Dhruv6576/CYTM-Digital-Timer/docs/superpowers/plans/2026-10-08-timer-pcb.md

# CYTM Digital Timer PCB Implementation Plan

> **For agentic workers:** REQUIRED SUB-SKILL: Use superpowers:subagent-driven-development (recommended) or superpowers:executing-plans to implement this plan task-by-task. Steps use checkbox (`- [ ]`) syntax for tracking.

**Goal:** Generate a complete, DRC/ERC-clean KiCad 10 project (schematic, 2-layer PCB, Gerbers, BOM, renders, 3×2 film panel) for the 24 VDC cyclic timer, from one Python circuit description.

**Architecture:** One Python file (`circuit.py`) holds every part, net and placement. Generators turn it into a `.kicad_sch` (symbols + net labels) and a `.kicad_pcb` (pcbnew API, run with KiCad's bundled Python). Freerouting routes the board through Specctra DSN/SES. `kicad-cli` runs ERC, DRC with schematic parity, and all exports. Plain-assert test scripts check the netlist against the firmware pin map.

**Tech Stack:** KiCad 10.0.6 (`kicad-cli`, bundled Python + `pcbnew`), Freerouting (jar, Java 17), Python 3.10 (user install) + PyMuPDF for the film panel.

**Spec:** `docs/superpowers/specs/2026-10-07-timer-pcb-design.md`

## Global Constraints

- Board 50 × 80 mm, portrait, 4 × M3 (3.2 mm) holes, 4 mm from each corner.
- 2 copper layers, 1.6 mm FR-4, 1 oz copper.
- Front (F) side: display, 4 LEDs, 3 keys, screw terminal only. Everything else on back (B).
- Design rules (JLCPCB-safe): track ≥ 0.25 mm, clearance ≥ 0.2 mm, via 0.6/0.3 mm.
- Net classes: `Load` (VIN_RAW, OUT_P) track 3.0 mm; `Power` (VIN, +5V, GND) track 0.6 mm; `Default` 0.25 mm.
- MCU pin map exactly as the spec table; firmware `Final/5-26.c` must not change.
- ERC: 0 errors. DRC: 0 errors, 0 unconnected items, schematic parity clean.
- No git repo in this folder: no commit steps.

## Review Focus

1. Symbol pin names for MG51FB9AE (N76E003AT20 symbol) differ from the assumed pinout → wrong board. Task 1 test prints and asserts the 20 pin names.
2. Display segment/digit pins swapped → wrong characters. Task 2 test asserts SEG_A..SEG_DP land on display pins named A..DP and DIG1..3 on CA1..3.
3. Load traces thinner than 3 mm → overheating at 5 A. Task 5 test asserts every track on VIN_RAW / OUT_P is ≥ 3.0 mm.
4. Reversed input feeds the logic or coil directly → damage. Task 2 test asserts only D1 anode, K1 COM and J1 pin 1 sit on VIN_RAW.
5. Tall part on the panel side, or SMD on the front → does not fit / not like reference. Task 4 test asserts side of every footprint.

---

## File Structure

```
hardware/
  scripts/
    env.py          # paths to kicad-cli, KiCad python, libraries, freerouting jar
    sexpr.py        # tiny S-expression parser/printer (for .kicad_sym and .kicad_sch)
    circuit.py      # parts, nets, placement: single source of truth
    gen_sch.py      # circuit.py -> timer.kicad_sch
    gen_pcb.py      # circuit.py -> timer.kicad_pcb (run with KiCad python)
    route.py        # pre-route load nets, Freerouting, import SES, fill zones
    export.py       # gerbers zip, drill, bom, pdf, renders
    films.py        # 3x2 film panel PDF + PNG preview
  tests/
    test_libs.py     # symbols/footprints exist, MCU pin names
    test_circuit.py  # netlist rules + firmware pin map
    test_pcb.py      # sides, widths, outline
  timer.kicad_pro / .kicad_sch / .kicad_pcb
  output/
```

---

### Task 1: Toolchain and library check

**Files:**
- Create: `hardware/scripts/env.py`, `hardware/scripts/sexpr.py`, `hardware/tests/test_libs.py`

**Interfaces:**
- Produces: `env.KICAD_CLI`, `env.KICAD_PY`, `env.SYM_DIR`, `env.FP_DIR`, `env.FREEROUTING`, `env.HW` (hardware dir).
  `sexpr.parse(text) -> list`, `sexpr.dump(node) -> str`, `sexpr.find(node, tag) -> list`.

- [ ] **Step 1:** Wait for the winget KiCad install; confirm `C:\Program Files\KiCad\10.0\bin\kicad-cli.exe version` prints 10.0.x.
- [ ] **Step 2:** Download Freerouting jar to `hardware/tools/freerouting.jar` (latest release that runs on Java 17; if 2.x needs Java 21, use 1.9.0). Run `java -jar freerouting.jar -help` to confirm.
- [ ] **Step 3:** `pip install pymupdf` into the user Python (tooling only).
- [ ] **Step 4:** Write `env.py`:

```python
from pathlib import Path
HW = Path(__file__).resolve().parents[1]
KICAD = Path(r"C:\Program Files\KiCad\10.0")
KICAD_CLI = KICAD / "bin" / "kicad-cli.exe"
KICAD_PY = KICAD / "bin" / "python.exe"
SYM_DIR = KICAD / "share" / "kicad" / "symbols"
FP_DIR = KICAD / "share" / "kicad" / "footprints"
FREEROUTING = HW / "tools" / "freerouting.jar"
```

- [ ] **Step 5:** Write `sexpr.py` (tokenizer for `(`, `)`, quoted strings with `\"` escapes, atoms; `dump` quotes atoms that contain spaces/parens/quotes or are empty).
- [ ] **Step 6:** Write `test_libs.py`: for every `lib_id` and `footprint` used in `circuit.PARTS`, assert the symbol exists in `SYM_DIR/<lib>.kicad_sym` and the footprint file exists in `FP_DIR/<lib>.pretty/<name>.kicad_mod`. Print the N76E003AT20 pin number → name table and assert:

```python
EXPECT = {"1":"P0.5","2":"P0.6","3":"P0.7","4":"P2.0","5":"P3.0","6":"P1.7","7":"VSS",
          "8":"P1.6","9":"VDD","10":"P1.5","11":"P1.4","12":"P1.3","13":"P1.2","14":"P1.1",
          "15":"P1.0","16":"P0.0","17":"P0.1","18":"P0.2","19":"P0.3","20":"P0.4"}
# names compared by prefix before the first "/"
```

- [ ] **Step 7:** Run `python hardware/tests/test_libs.py` → expect `ok`. Any missing symbol: pick the nearest real KiCad library part, update `circuit.py`, rerun.

### Task 2: Circuit description

**Files:**
- Create: `hardware/scripts/circuit.py`, `hardware/tests/test_circuit.py`

**Interfaces:**
- Produces: `PARTS: dict[ref, Part]` where `Part = (lib_id, value, footprint, side, x, y, rot)`; side `"F"`/`"B"`, x/y in mm from board top-left.
  `NETS: dict[net_name, list[(ref, pin)]]`, pin = pin number or pin name (resolved by prefix match against the symbol).
  `NETCLASS: dict[net_name, "Load"|"Power"]`.

- [ ] **Step 1: Write the failing test** `test_circuit.py`:

```python
import sys; sys.path.insert(0, str(__import__("pathlib").Path(__file__).parents[1] / "scripts"))
from circuit import PARTS, NETS
FW = {"SEG_A":"P0.0","SEG_B":"P0.2","SEG_C":"P0.5","SEG_D":"P1.2","SEG_E":"P1.1",
      "SEG_F":"P0.1","SEG_G":"P1.4","SEG_DP":"P1.3","DRV1":"P1.0","DRV2":"P0.3",
      "DRV3":"P0.4","DRVL":"P0.6","RELAY":"P0.7","KEY_SET":"P1.7","KEY_START":"P2.0",
      "KEY_STOP":"P3.0","ICE_DAT":"P1.6"}
for net, pin in FW.items():
    assert ("U1", pin) in NETS[net], (net, pin)
seen = set()
for net, pins in NETS.items():
    assert len(pins) >= 2, net
    for p in pins:
        assert p[0] in PARTS, p
        assert p not in seen, ("pin on two nets", p); seen.add(p)
for s in "A B C D E F G DP".split():
    assert ("U3", s) in NETS[f"SEG_{s}_D"], s
for i in (1, 2, 3):
    assert ("U3", f"CA{i}") in NETS[f"DIG{i}"]
assert sorted(NETS["VIN_RAW"]) == sorted([("J1","1"),("D1","2"),("K1","COM")])  # D1 pin 2 = anode
print("ok")
```

- [ ] **Step 2:** Run it → FAIL (`No module named circuit`).
- [ ] **Step 3:** Write `circuit.py` with all parts from the spec (refs U1, U2, U3 display, Q1–Q5, R1–R15, C1–C5, D1–D3, LED1–LED4, SW1–SW3, K1, J1, J2, H1–H4) and nets:
  - SEG_x: U1 pin → Rn pin 1; SEG_x_D: Rn pin 2 → U3 segment (+ LED cathodes: LED1 SEC on A, LED4 ON/OFF on B, LED2 MIN on C, LED3 SET on F).
  - DRVn: U1 pin → R9–R12 pin 1; BASEn: R pin 2 → Qn base; Qn collector → +5V; Qn emitter → DIG1/DIG2/DIG3/LED_COM. LED anodes on LED_COM.
  - RELAY: U1 P0.7 → R13; RLY_B: R13, R14, Q5 B; R14 pin 2 → GND; Q5 E → GND; RLY_COIL: Q5 C, K1 coil 2, D3 anode; VIN: K1 coil 1, D3 cathode, D1 cathode, D2 cathode, C1 +, C2, U2 IN.
  - VIN_RAW: J1.1, D1 anode, K1 COM. OUT_P: K1 NO, J1.3. GND: J1.2, J1.4 and all grounds.
  - +5V: U2 OUT, C3, C4, C5, U1 VDD, Q1–Q4 collectors, R15, J2.1.
  - KEY_SET/KEY_START/KEY_STOP: U1 pin + SW pin 1; SW pin 2 → GND; R15 on KEY_START; J2.4 on KEY_START; J2.2 ICE_DAT; J2.3 on SEG_B.
  - Placement from the spec's front layout (LED row y=8, display centered y≈24, STOP/START y=48, SET y=58, terminal on bottom edge y≈73; relay, regulator, MCU, passives on B).
- [ ] **Step 4:** Run test → `ok`.

### Task 3: Schematic generator

**Files:**
- Create: `hardware/scripts/gen_sch.py`
- Output: `hardware/timer.kicad_sch`, `hardware/timer.kicad_pro`

**Interfaces:**
- Consumes: `circuit.PARTS`, `circuit.NETS`, `sexpr`, `env`.
- Produces: `timer.kicad_sch` whose netlist equals `NETS`.

- [ ] **Step 1:** Generator: copy each used symbol from its `.kicad_sym` into `lib_symbols` (rename to `Lib:Name`, resolve `extends`). Place symbols on an A3 grid, functional groups in columns (power, MCU, display, relay, keys). For each connected pin compute the pin end point (symbol origin + rotated pin `at`, Y inverted) and attach a `label` with the net name; power nets use `global_label`. Unconnected pins get `no_connect`. Add `PWR_FLAG` on VIN_RAW, GND, +5V. Write UUIDs with `uuid.uuid4()`, KiCad 10 file version from a fresh `kicad-cli` project.
- [ ] **Step 2:** Run `python hardware/scripts/gen_sch.py`.
- [ ] **Step 3:** `kicad-cli sch erc --severity-error --exit-code-violations hardware/timer.kicad_sch` → 0 errors.
- [ ] **Step 4:** `kicad-cli sch export netlist --format kicadsexpr` → add to `test_circuit.py` a parse of that netlist and assert its net membership equals `NETS` (pin names mapped to numbers). Run → `ok`.
- [ ] **Step 5:** `kicad-cli sch export pdf` → open the PDF image, check labels readable and no overlaps.

### Task 4: PCB generator

**Files:**
- Create: `hardware/scripts/gen_pcb.py`, `hardware/tests/test_pcb.py`
- Output: `hardware/timer.kicad_pcb`

**Interfaces:**
- Consumes: `circuit.*`, schematic netlist (pin names → numbers), `env.FP_DIR`.
- Produces: placed, unrouted `timer.kicad_pcb` with nets, net classes, outline, holes, GND zones.

- [ ] **Step 1: Failing test** `test_pcb.py` (run with `KICAD_PY`): load board; assert outline bbox 50×80 mm; display, LEDs, keys, J1 on F.Cu; every other footprint on B.Cu; every pad in `NETS` has the expected net; footprints do not leave the outline.
- [ ] **Step 2:** Run → FAIL (file missing).
- [ ] **Step 3:** `gen_pcb.py`: `pcbnew.NewBoard`, 2 layers, design settings from Global Constraints, net classes, Edge.Cuts rectangle with 1 mm corner radius, 4 × `MountingHole_3.2mm_M3` footprints, `FootprintLoad` each part, set reference/value, position (board origin at (100,100) mm), `Flip` for side B, assign pad nets by pin number, add GND `ZONE` on F.Cu and B.Cu (0.3 mm clearance, thermal reliefs), copper keep-out under relay contacts not needed at 24 V. Silkscreen: front labels SEC / MIN / SET / ON/OFF over LEDs, STOP / START / SET under keys, "IN+ IN- OUT+ OUT-" over J1, "CYTM V5" and date on back.
- [ ] **Step 4:** Run gen + test → `ok`.
- [ ] **Step 5:** `kicad-cli pcb drc --schematic-parity` → parity clean, courtyard clean (unconnected items expected until Task 5).

### Task 5: Routing

**Files:**
- Create: `hardware/scripts/route.py`
- Modify: `hardware/tests/test_pcb.py` (add width + unrouted checks)

**Interfaces:**
- Consumes: `timer.kicad_pcb` from Task 4, `env.FREEROUTING`.
- Produces: fully routed `timer.kicad_pcb`.

- [ ] **Step 1: Failing test:** add to `test_pcb.py`: every track on VIN_RAW / OUT_P ≥ 3.0 mm; every track on Power nets ≥ 0.6 mm; `board.GetConnectivity().GetUnconnectedCount(False) == 0`.
- [ ] **Step 2:** Run → FAIL (unrouted).
- [ ] **Step 3:** `route.py`: pre-route Load nets as locked 3 mm F.Cu tracks (J1.1 → K1 COM, K1 NO → J1.3) plus GND J1.2 ↔ J1.4; `pcbnew.ExportSpecctraDSN`; run `java -jar freerouting.jar -de timer.dsn -do timer.ses -mp 30`; `pcbnew.ImportSpecctraSES`; fill zones with `ZONE_FILLER`; save.
- [ ] **Step 4:** Run route + test → `ok`.
- [ ] **Step 5:** `kicad-cli pcb drc --schematic-parity --severity-error --exit-code-violations` → 0 errors, 0 unconnected. On failure: move parts in `circuit.py`, rerun Tasks 4–5.

### Task 6: Fabrication outputs

**Files:**
- Create: `hardware/scripts/export.py`
- Output: `hardware/output/{gerbers.zip, bom.csv, schematic.pdf, render_top.png, render_bottom.png}`

- [ ] **Step 1:** `export.py` runs `kicad-cli pcb export gerbers` (F/B Cu, Mask, Paste, Silk, Edge.Cuts), `kicad-cli pcb export drill` (Excellon, mm), zips them; `kicad-cli sch export bom` (Reference, Value, Footprint, Qty, grouped by value); `kicad-cli sch export pdf`; `kicad-cli pcb render --side top/bottom --quality high`.
- [ ] **Step 2:** Run; assert all files exist and the zip holds ≥ 9 Gerber files + drill.
- [ ] **Step 3:** View both renders; check display, keys, LEDs, terminal on front and relay/MCU on back.

### Task 7: Film panel (like the reference)

**Files:**
- Create: `hardware/scripts/films.py`
- Output: `hardware/output/films_panel_3x2.pdf`, `hardware/output/films_preview.png`

- [ ] **Step 1:** `kicad-cli pcb export pdf` one PDF per film: B.Cu (copper), F.Cu, B.Mask, F.Silkscreen, B.Silkscreen, each with Edge.Cuts, black-and-white, 1:1.
- [ ] **Step 2:** `films.py` (PyMuPDF): one page per film, 3 columns × 2 rows of the board with `show_pdf_page`, red 0.3 mm cut lines on board edges, title + scale bar (10 mm) per page. Page size = 3×50 + 2×10 mm by 2×80 + 2×10 mm + title band.
- [ ] **Step 3:** Rasterize page 1 at 300 dpi to `films_preview.png`; assert page size within 0.1 mm of expected; view it.

### Task 8: Final review

- [ ] **Step 1:** Run all three test scripts, ERC and DRC again → all clean.
- [ ] **Step 2:** Write `hardware/README.md`: how to regenerate (one command per script), what is assumed (pinout, display, enclosure), production checks list from the spec.
- [ ] **Step 3:** Dispatch one reviewer subagent over `hardware/` against the spec.
