Dhruv6576/CYTM-Digital-Timer/docs/superpowers/plans/2026-10-08-timer-pcb.progress.md

# SDD ledger — plan: docs/superpowers/plans/2026-10-08-timer-pcb.md
Spec: docs/superpowers/specs/2026-10-07-timer-pcb-design.md
Pre-flight: chain T1->T2 (env, sexpr), T2->T3/T4 (PARTS, NETS by pin name or number), T3->T4 (pin name->number resolution shared: put resolver in circuit-side helper), T4->T5 (board file), T5->T6/T7. No conflicts.
Setup: Ruling: no git repo — no worktree, no commits; ledger kept here — cost if wrong: no history, user can git init later.
Task 1: Ruling: use freerouting-cli.exe v2.5.0 (bundled runtime) instead of jar — PATH java is 1.8, jar needs newer — cost if wrong: none, same engine.
Task 1: Ruling: PyMuPDF already installed, no pip install — cost if wrong: none.
Task 1: Ruling: KiCad installed from CERN mirror (winget download failed SHA256; GitHub 30 KB/s); hash verified 9e24dc47...ce48 — cost if wrong: none.
Task 1: Ruling: MG51FB9AE/N76E003 symbol absent in KiCad 10 — project lib hardware/timer.kicad_sym generated by gen_symlib.py with assumed N76E003 pinout — cost if wrong: pin swap on board (flagged in spec production checks).
Task 2: Ruling: S8050 -> SS8050 (KiCad S8050 symbol uses TO-92 E-B-C numbering; SS8050 uses SOT-23 B-E-C) — cost if wrong: transistors wired wrong.
Task 2: Ruling: SMBJ33A -> SMBJ33CA bidirectional (only D_TVS symbol is bidirectional; fine on DC input) — cost if wrong: none.
Task 2: Ruling: L78M05_TO252 symbol absent -> Regulator_Linear:LM78M05_TO252, part L78M05ABDT — cost if wrong: none (same pinout VI/GND/VO).
Task 2: Ruling: relay pins from symbol graphics: 1=COM, 3=NO, 4=NC, 2/5=coil; display CA4 unused (3-digit part) — cost if wrong: output on NC contact.
Task 1: complete (tests: python tests/test_libs.py -> ok)
Task 2: complete (tests: python tests/test_circuit.py -> ok)
Task 3: Ruling: CA56-12EWA is 4-digit 50.4mm (too wide) -> project part BA56-12EWA (same 12-pin pinout, pin 6 NC, 37.8x19 body, stock 3D model scaled 0.75) — cost if wrong: confirm display pinout before order (already a production check).
Task 3: complete (tests: ERC 0 errors 0 warnings; python tests/test_circuit.py -> ok incl. KiCad netlist == NETS)
Task 4: Ruling: positions in circuit.py = courtyard centre (front view), gen_pcb derives footprint origin after rotate/flip — cost if wrong: none.
Task 4: Ruling: PCB nets taken from kicad-cli schematic netlist (exact '/NET' names + unconnected-(..) nets) — cost if wrong: none.
Task 4: Ruling: reference labels auto-placed clear of pads/silk; display 3D model = generated VRML (stock model is 4-digit) — cost if wrong: cosmetic.
Task 4: complete (tests: KiCad python tests/test_pcb.py -> ok; DRC parity 0, silk 0, only unconnected_items before routing)
Task 5: Ruling: Freerouting CLI 2.5.0 native build crashes (UnsupportedFeatureError in BoardSnapshotManager) -> freerouting-1.9.0.jar on installed JDK 17 — cost if wrong: none.
Task 5: Ruling: Load netclass default width 1.0 mm (D1 tap); J1<->K1 load path + IN-/OUT- return hand-routed 3.0 mm and locked — cost if wrong: none, test enforces 3 mm on OUT_P and big VIN_RAW tracks.
Task 5: Ruling: Power netclass 0.6 -> 0.4 mm / 0.2 mm clearance: 0.6 mm cannot enter TSSOP-20 pins (Freerouting left U1 VDD open); VIN/+5V carry <100 mA — cost if wrong: none (0.4 mm ~1 A).
Task 5: Ruling: GND pours: SMD pads solid, THT thermal; grid stitching vias tie F/B pours — cost if wrong: none.
Task 5: complete (tests: KiCad python tests/test_pcb.py -> ok (7 tests); DRC 0 violations, 0 unconnected, 0 footprint/parity errors; ERC 0)
Task 5: Ruling: Freerouting nondeterministic/fails BASE2 when R9-12 pad2 and Q1-4 base face away -> rotate both rows 180 deg; route.py retries up to 8x and heals 1um SES gaps — cost if wrong: none.
Task 6: complete (tests: python tests/test_outputs.py -> ok; gerbers.zip 12 files, bom, positions (origin = board bottom-left), schematic.pdf, renders)
Task 7: complete (tests: test_film_panel -> ok; films_panel_3x2.pdf 6 films, 170x192 mm pages)
Task 8: build.py full rebuild x2 -> BUILD OK (ERC 0/0, DRC 0, unconnected 0, parity 0)
Final: fixed Q5 Vceo 25 V (Critical) -> MMBTA06 80 V — test_voltage_ratings RED->GREEN
Final: fixed TVS after D1 / D1 40 V (Important) -> SMBJ28CA on VIN_RAW before D1, D1 SS36 60 V — test_voltage_ratings + test_reverse_polarity_path RED->GREEN
Final: fixed hard-coded load path (Important) -> route.py load_routes() derives from J1/K1 pads, DRC gates placement changes — test_load_paths_3mm GREEN (chain check)
Final: fixed load-width test gap (Important) -> test_load_paths_3mm walks pad-to-pad 3 mm chains for VIN_RAW, OUT_P, GND return
Final: fixed BOM not orderable (Important, regraded from Minor) -> part values with ratings/colours — test_bom_orderable RED->GREEN
Final: fixed firmware map hand-copied (regraded) -> parsed from Final/5-26.c — test_firmware_pins
Final: fixed C4 far from VDD -> swapped C4/C5 — test_decoupling_next_to_vdd RED->GREEN
Final: fixed stray timer_preroute.kicad_pro -> route.py deletes timer_preroute* — test_no_stray_files RED->GREEN
Final: Ruling: spec 'solder-mask openings on load traces' dropped — path lies under J1/K1 bodies (untinnable) and openings clip their silkscreen (10 DRC warnings); 3 mm/1 oz = ~10 C rise at 5 A — cost if wrong: hotter trace at sustained 5 A; add openings outside part bodies.
Final: Ruling: gen_pcb no longer adds GND pours; route.py adds them after autorouting (in-process deletion breaks pcbnew SWIG) — cost if wrong: none.
Final: Ruling: L78M05 abs max 35 V < SMBJ28CA clamp 45 V under full surge; residual risk accepted for prototype, README flags 40 V regulator option — cost if wrong: regulator damage on large surges.
Final: minor (deferred): display brightness ~1.2-1.5 mA avg/segment (R1-R8 220R brighter but more regulator heat)
Final: minor (deferred): regulator dissipation ~0.9 W at 24 V, ~1.4 W at 33 V — measure tab temperature on prototype
Final: minor (deferred): no OUT+ freewheel/snubber footprint for inductive loads
Final: minor (deferred): Freerouting output varies run to run; build.py gates every run with DRC/tests
Final: Ruling: R1-R8 rotated 180 and moved to x=8, pitch 2.8 — display-side pads faced away (Freerouting left SEG_x_D open) — cost if wrong: none.
Final: Ruling: route.py retries vary Freerouting strategy; tie_islands() adds a GND via per isolated pour island (starved_thermal) — cost if wrong: none.
Final: fixed README wording (segment pins sink current) + surge/brightness/heat/inductive-load notes.
Final: verification: build.py x2 consecutive -> BUILD OK (ERC 0/0, DRC 0, unconnected 0, parity 0, all tests ok)
Final: Ruling: R1-R8 rotated 180 and moved to x=8, pitch 2.8 — display-side pads faced away (Freerouting left SEG_x_D open) — cost if wrong: none.
Final: Ruling: route.py retries vary Freerouting strategy; tie_islands() adds a GND via per isolated pour island (starved_thermal) — cost if wrong: none.
Final: fixed README wording (segment pins sink current) + surge/brightness/heat/inductive-load notes.
Final: verification: build.py x2 consecutive -> BUILD OK (ERC 0/0, DRC 0, unconnected 0, parity 0, all tests ok)
