Dhruv6576/CYTM-Digital-Timer/hardware/output/films_preview.png

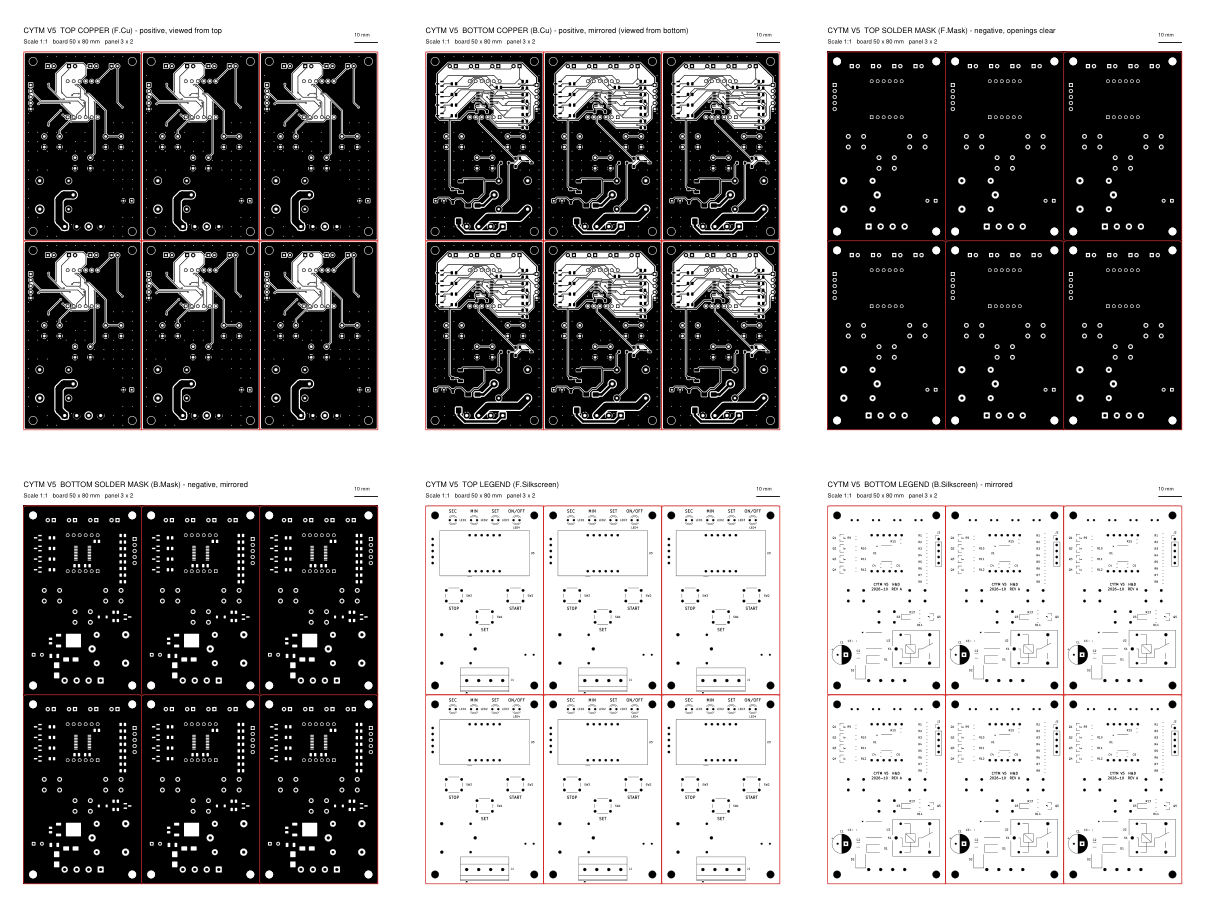
hardware/output/films_preview.png
