Dhruv6576/CYTM-Digital-Timer/hardware/output/render_bottom.png

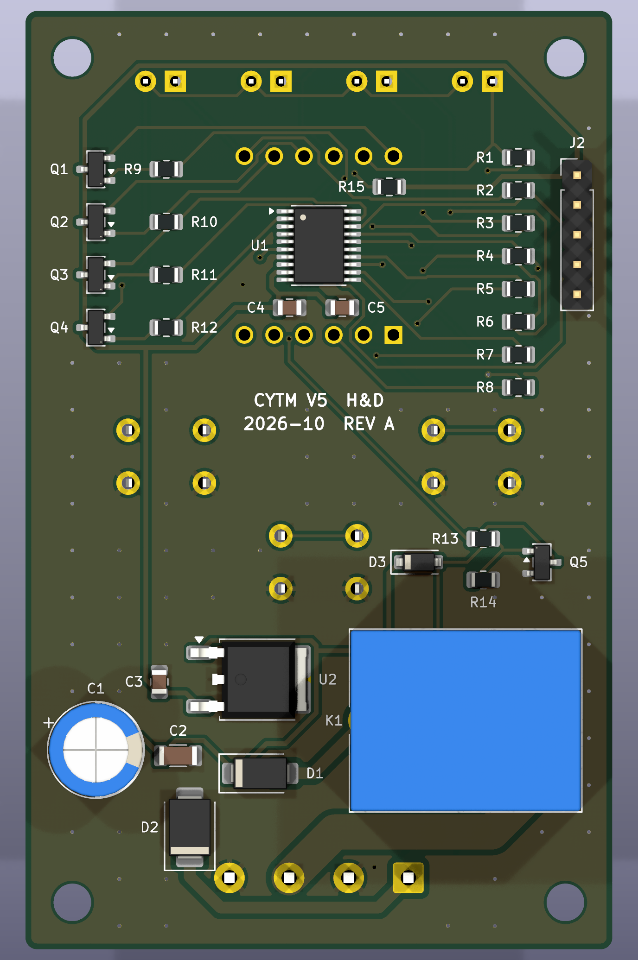
hardware/output/render_bottom.png
