Dhruv6576/CYTM-Digital-Timer/hardware/output/render_top.png

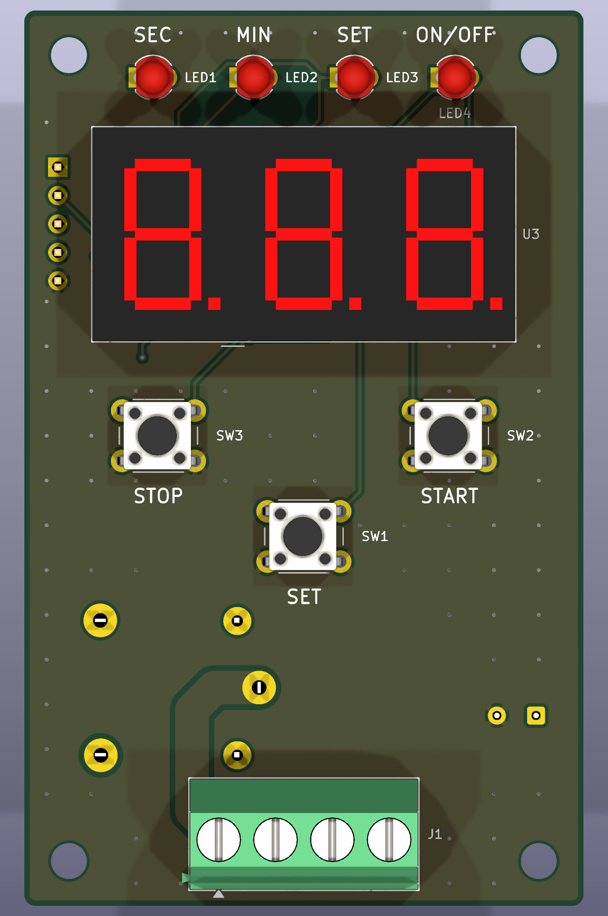
hardware/output/render_top.png
