Dhruv6576/CYTM-Digital-Timer/resources/board_back_smd_relay_regulator.jpeg

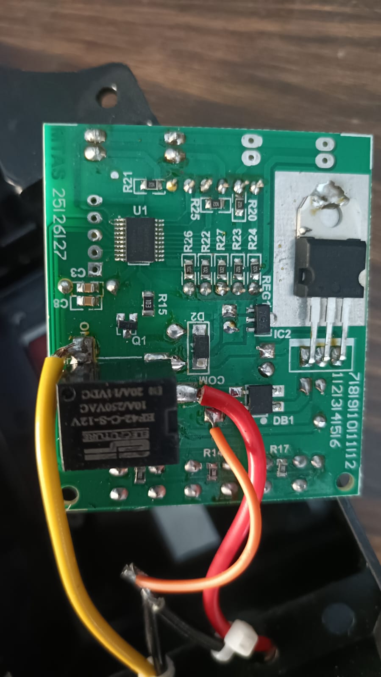
resources/board_back_smd_relay_regulator.jpeg
