Dhruv6576/CYTM-Digital-Timer/resources/board_front_display_buttons.jpeg

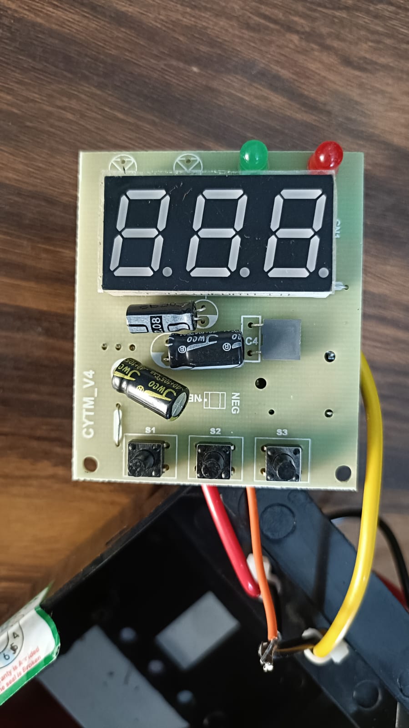
resources/board_front_display_buttons.jpeg
