Dhruv6576/CYTM-Digital-Timer/resources/enclosure_front_panel_24VDC.jpeg

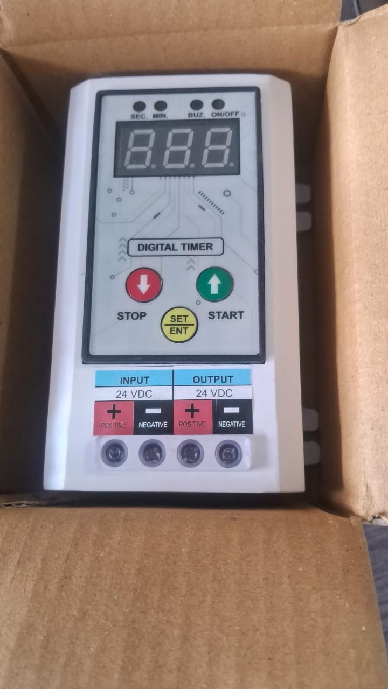
resources/enclosure_front_panel_24VDC.jpeg
