Dhruv6576/CYTM-Digital-Timer/resources/mcu_MG51FB9AE_TSSOP20_closeup.jpeg

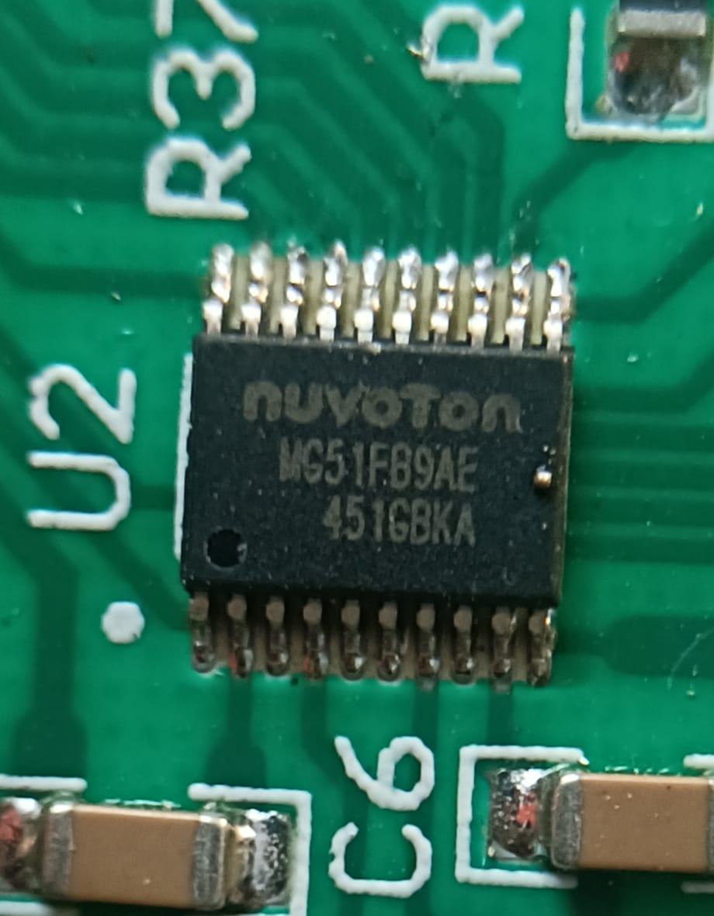
resources/mcu_MG51FB9AE_TSSOP20_closeup.jpeg
