Dhruv6576/CYTM-Digital-Timer/resources/reference_pcb_panel_80x50mm.png

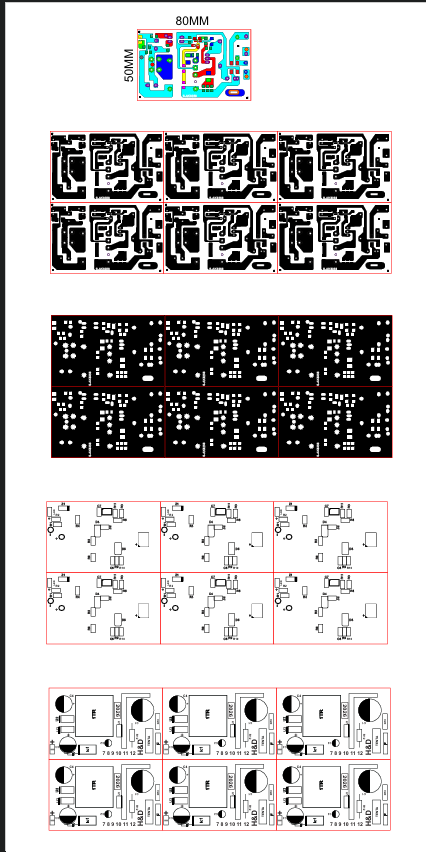
resources/reference_pcb_panel_80x50mm.png
