Dhruv6576/CYTM-Digital-Timer/hardware/output/bom.csv

Refs | Value | Footprint | Qty
C1 | 100uF 50V | Capacitor_THT:CP_Radial_D8.0mm_P3.50mm | 1
C2 | 10uF 50V X7R | Capacitor_SMD:C_1206_3216Metric | 1
C3,C5 | 10uF 16V X5R | Capacitor_SMD:C_0805_2012Metric | 2
C4 | 100nF 50V X7R | Capacitor_SMD:C_0805_2012Metric | 1
D1 | SS36 | Diode_SMD:D_SMA | 1
D2 | SMBJ28CA | Diode_SMD:D_SMB | 1
D3 | 1N4148W | Diode_SMD:D_SOD-123 | 1
J1 | MKDS 1,5/4-5,08 | TerminalBlock_Phoenix:TerminalBlock_Phoenix_MKDS-1,5-4-5.08_1x04_P5.08mm_Horizontal | 1
J2 | PinHeader 1x5 2.54mm (ICP) | Connector_PinHeader_2.54mm:PinHeader_1x05_P2.54mm_Vertical | 1
K1 | SRD-24VDC-SL-C | Relay_THT:Relay_SPDT_SANYOU_SRD_Series_Form_C | 1
LED1,LED2,LED3 | LED 3mm red | LED_THT:LED_D3.0mm | 3
LED4 | LED 3mm green | LED_THT:LED_D3.0mm | 1
Q1,Q2,Q3,Q4 | SS8050 | Package_TO_SOT_SMD:SOT-23 | 4
Q5 | MMBTA06 | Package_TO_SOT_SMD:SOT-23 | 1
R1,R2,R3,R4,R5,R6,R7,R8 | 330 | Resistor_SMD:R_0805_2012Metric | 8
R9,R10,R11,R12,R13 | 1k | Resistor_SMD:R_0805_2012Metric | 5
R14,R15 | 10k | Resistor_SMD:R_0805_2012Metric | 2
SW1,SW2,SW3 | Tact 6x6x5mm | Button_Switch_THT:SW_PUSH_6mm | 3
U1 | MG51FB9AE | Package_SO:TSSOP-20_4.4x6.5mm_P0.65mm | 1
U2 | L78M05ABDT | Package_TO_SOT_SMD:TO-252-2 | 1
U3 | BA56-12EWA | timer:Display_3Digit_0.56in_CA | 1
