Dhruv6576/CYTM-Digital-Timer/hardware/output/films_panel_3x2.pdf

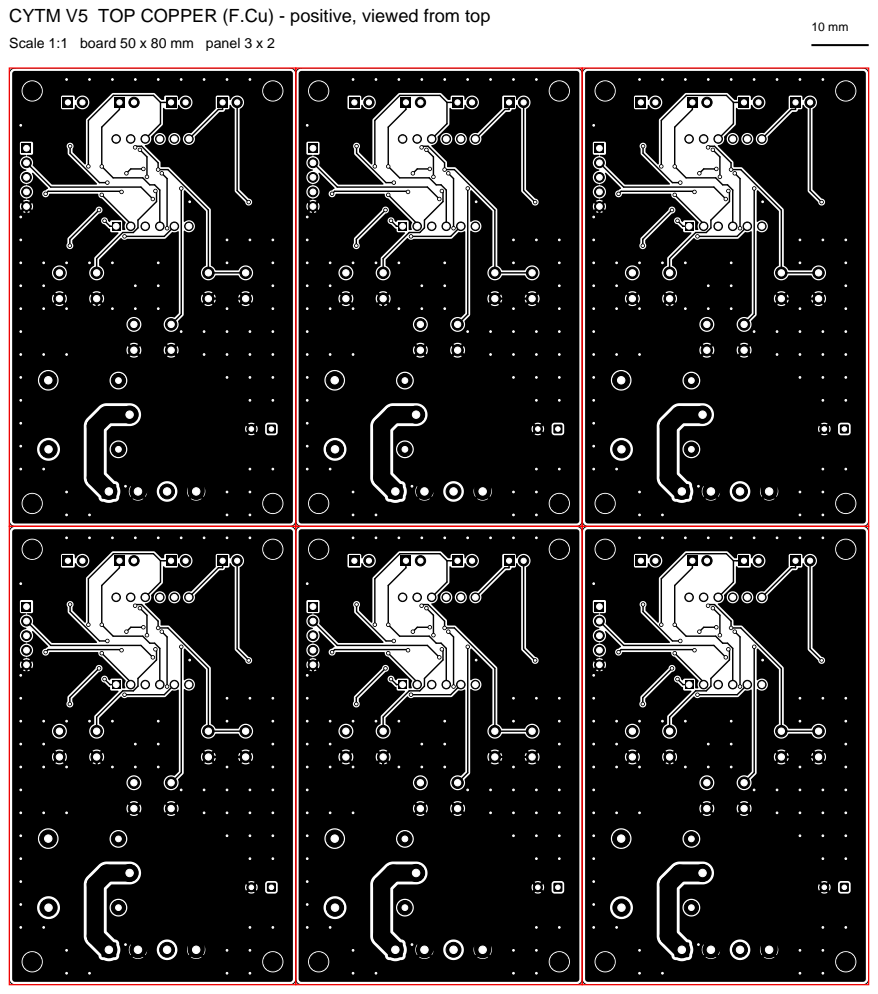
[picture p10: page 1]

CYTM V5 TOP COPPER (F.Cu) - positive, viewed from top
Scale 1:1 board 50 x 80 mm panel 3 x 2

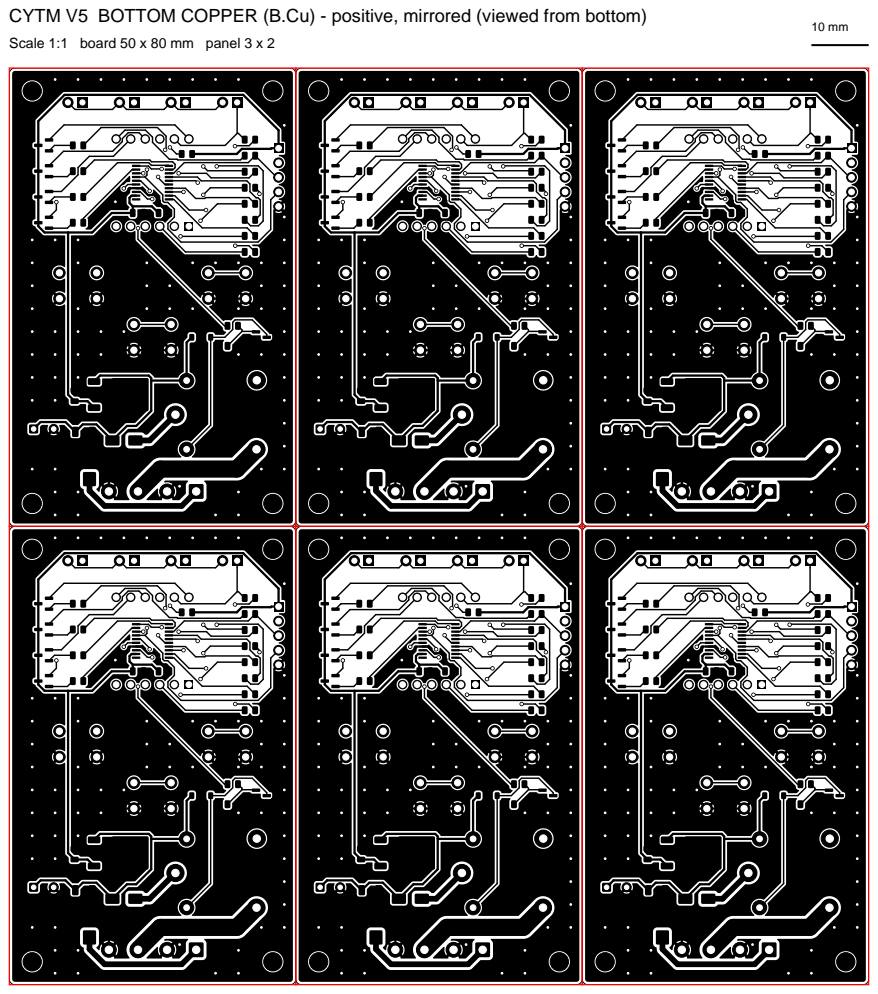
[picture p11: page 2]

CYTM V5 BOTTOM COPPER (B.Cu) - positive, mirrored (viewed from bottom)
Scale 1:1 board 50 x 80 mm panel 3 x 2

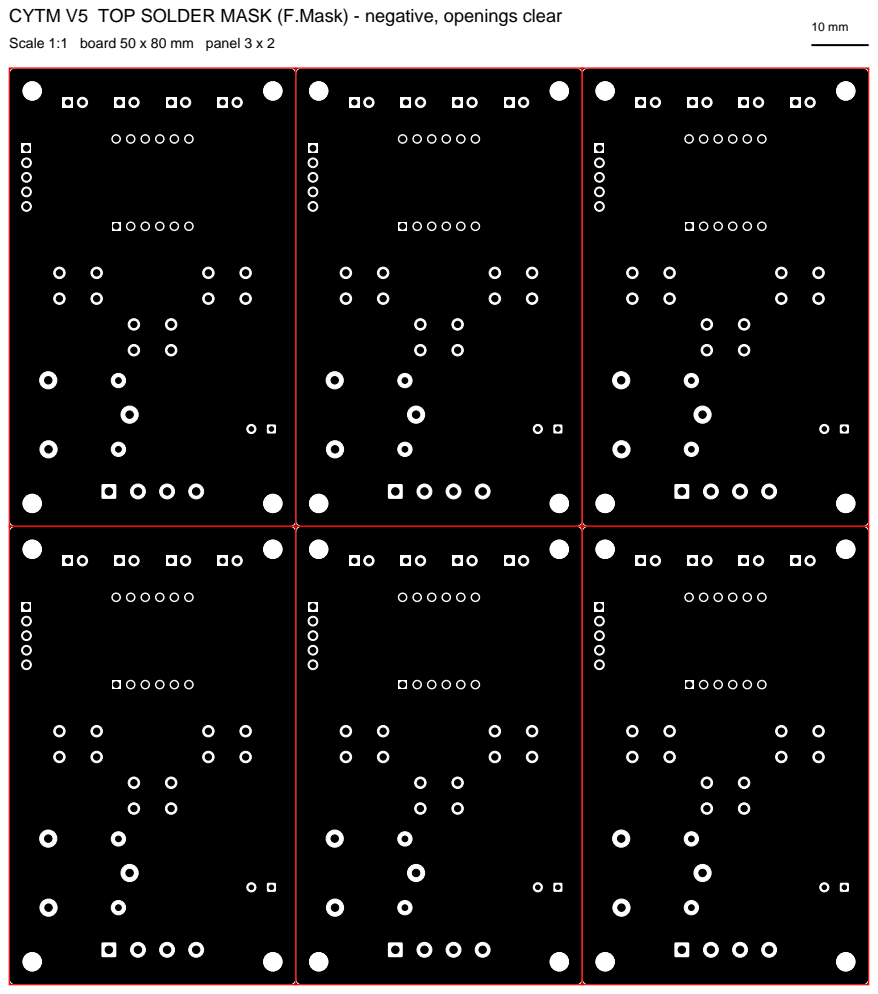
[picture p12: page 3]

CYTM V5 TOP SOLDER MASK (F.Mask) - negative, openings clear
Scale 1:1 board 50 x 80 mm panel 3 x 2

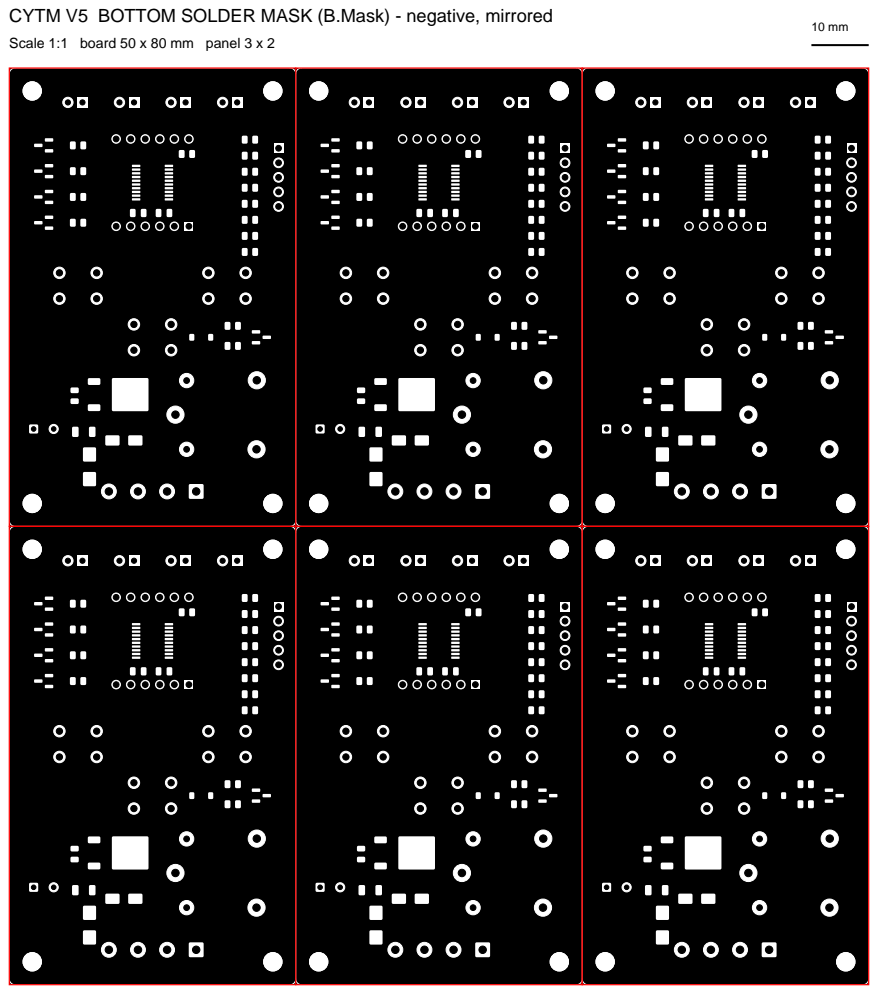
[picture p13: page 4]

CYTM V5 BOTTOM SOLDER MASK (B.Mask) - negative, mirrored
Scale 1:1 board 50 x 80 mm panel 3 x 2

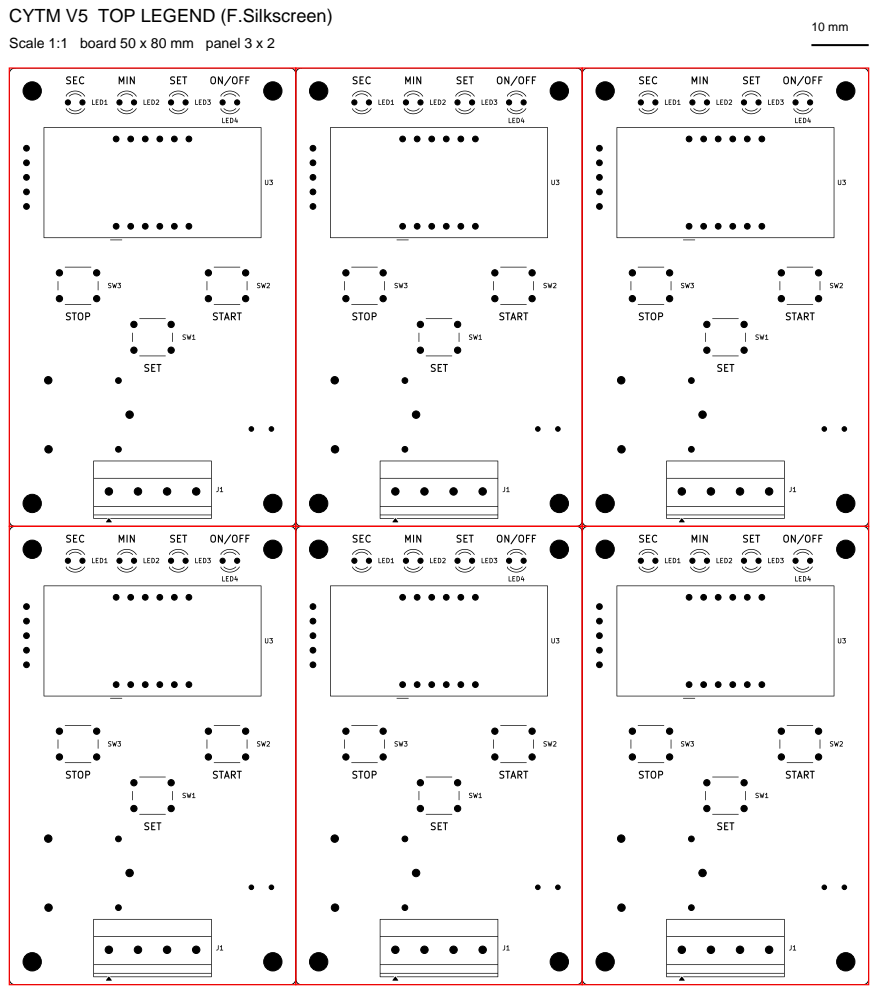
[picture p14: page 5]

CYTM V5 TOP LEGEND (F.Silkscreen)
Scale 1:1 board 50 x 80 mm panel 3 x 2

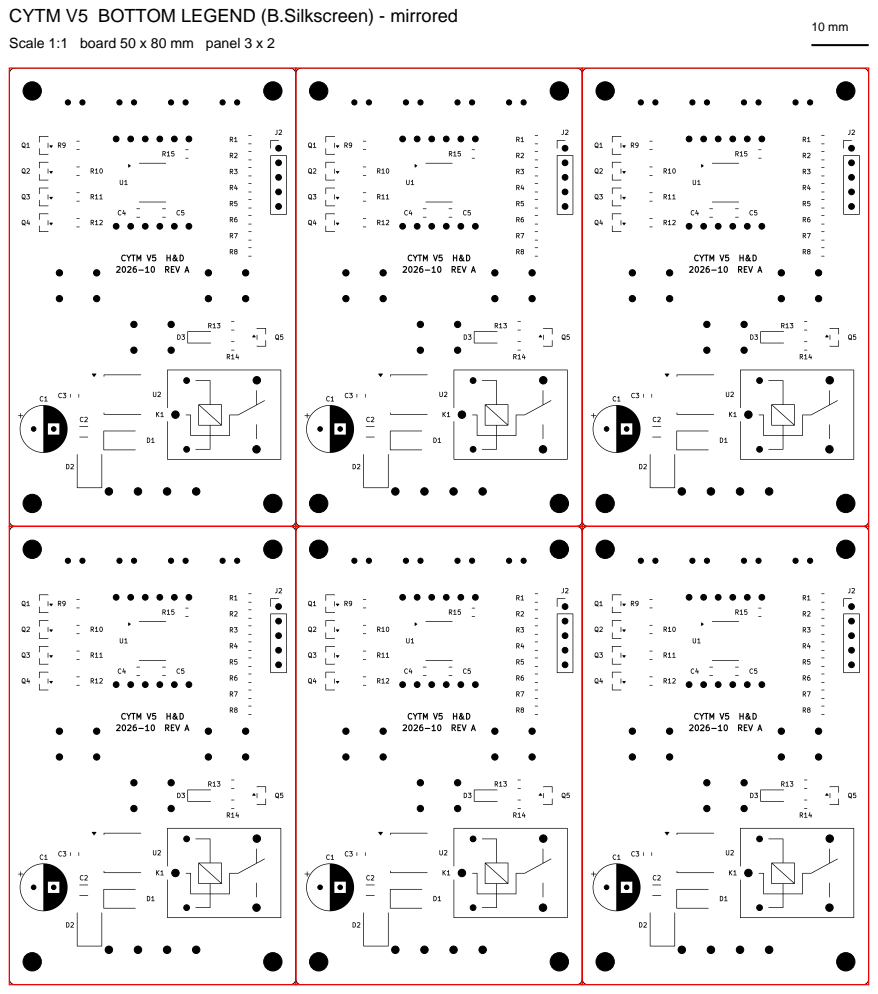
[picture p15: page 6]

CYTM V5 BOTTOM LEGEND (B.Silkscreen) - mirrored
Scale 1:1 board 50 x 80 mm panel 3 x 2
