Dhruv6576/CYTM-Digital-Timer/hardware/output/schematic.pdf

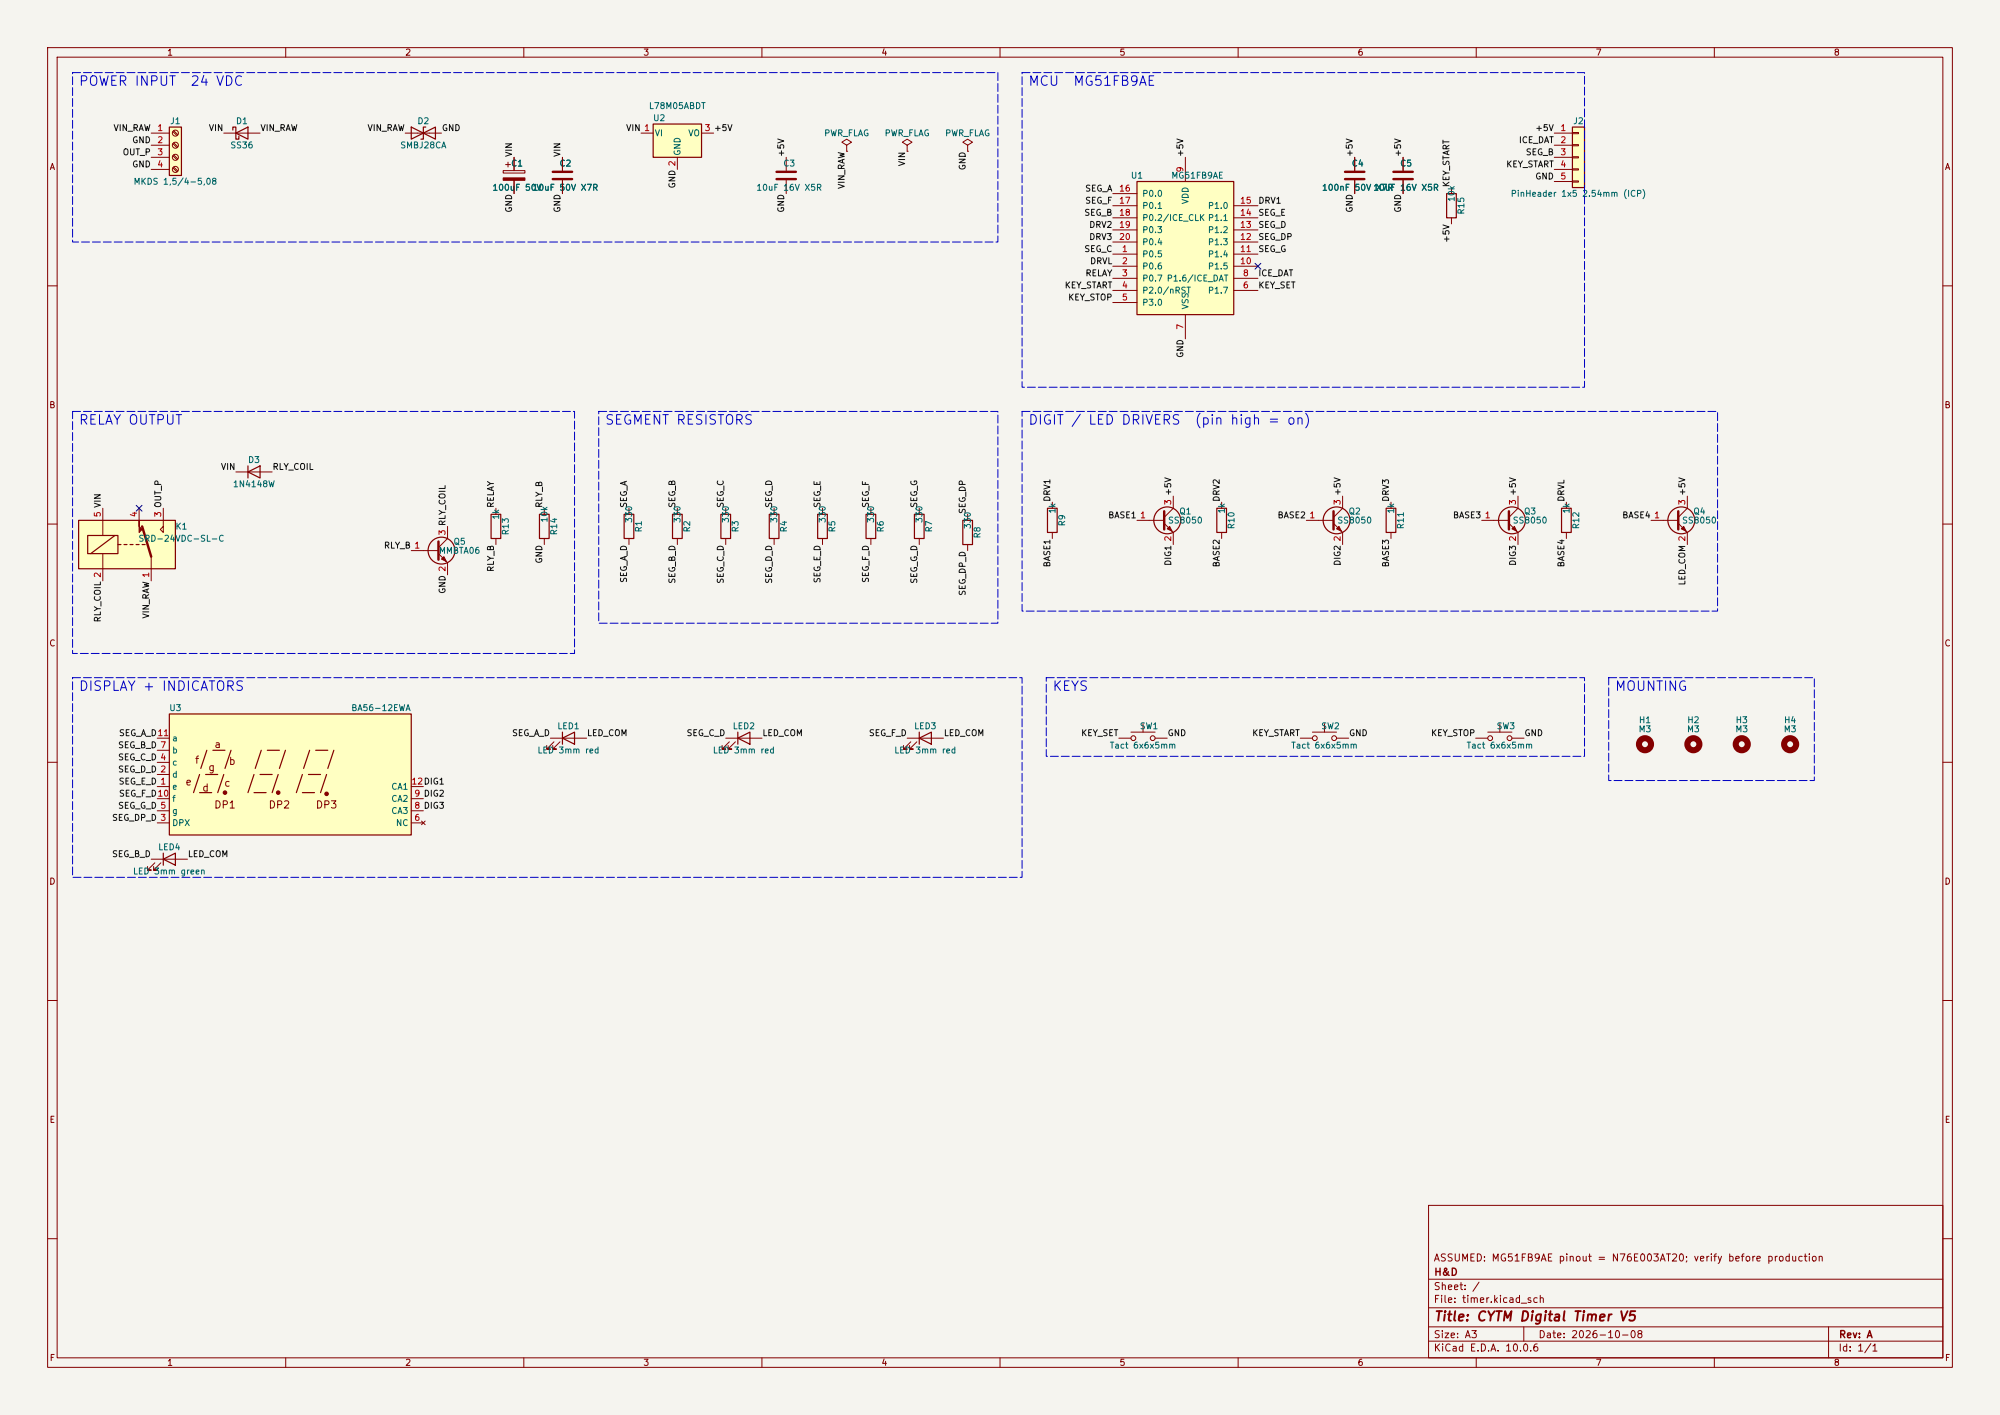
[picture p16: page 1]

ASSUMED: MG51FB9AE pinout = N76E003AT20; verify before production
Sheet: /
File: timer.kicad_sch
Title: CYTM Digital Timer V5

Size: A3 | Rev: A | F Date: 2026-10-08
KiCad E.D.A. 10.0.6 | Id: 1/1
