Dhruv6576/CYTM-Digital-Timer/hardware/timer.kicad_pcb

## KiCad design hardware/timer.kicad_pcb (2026-10-08)

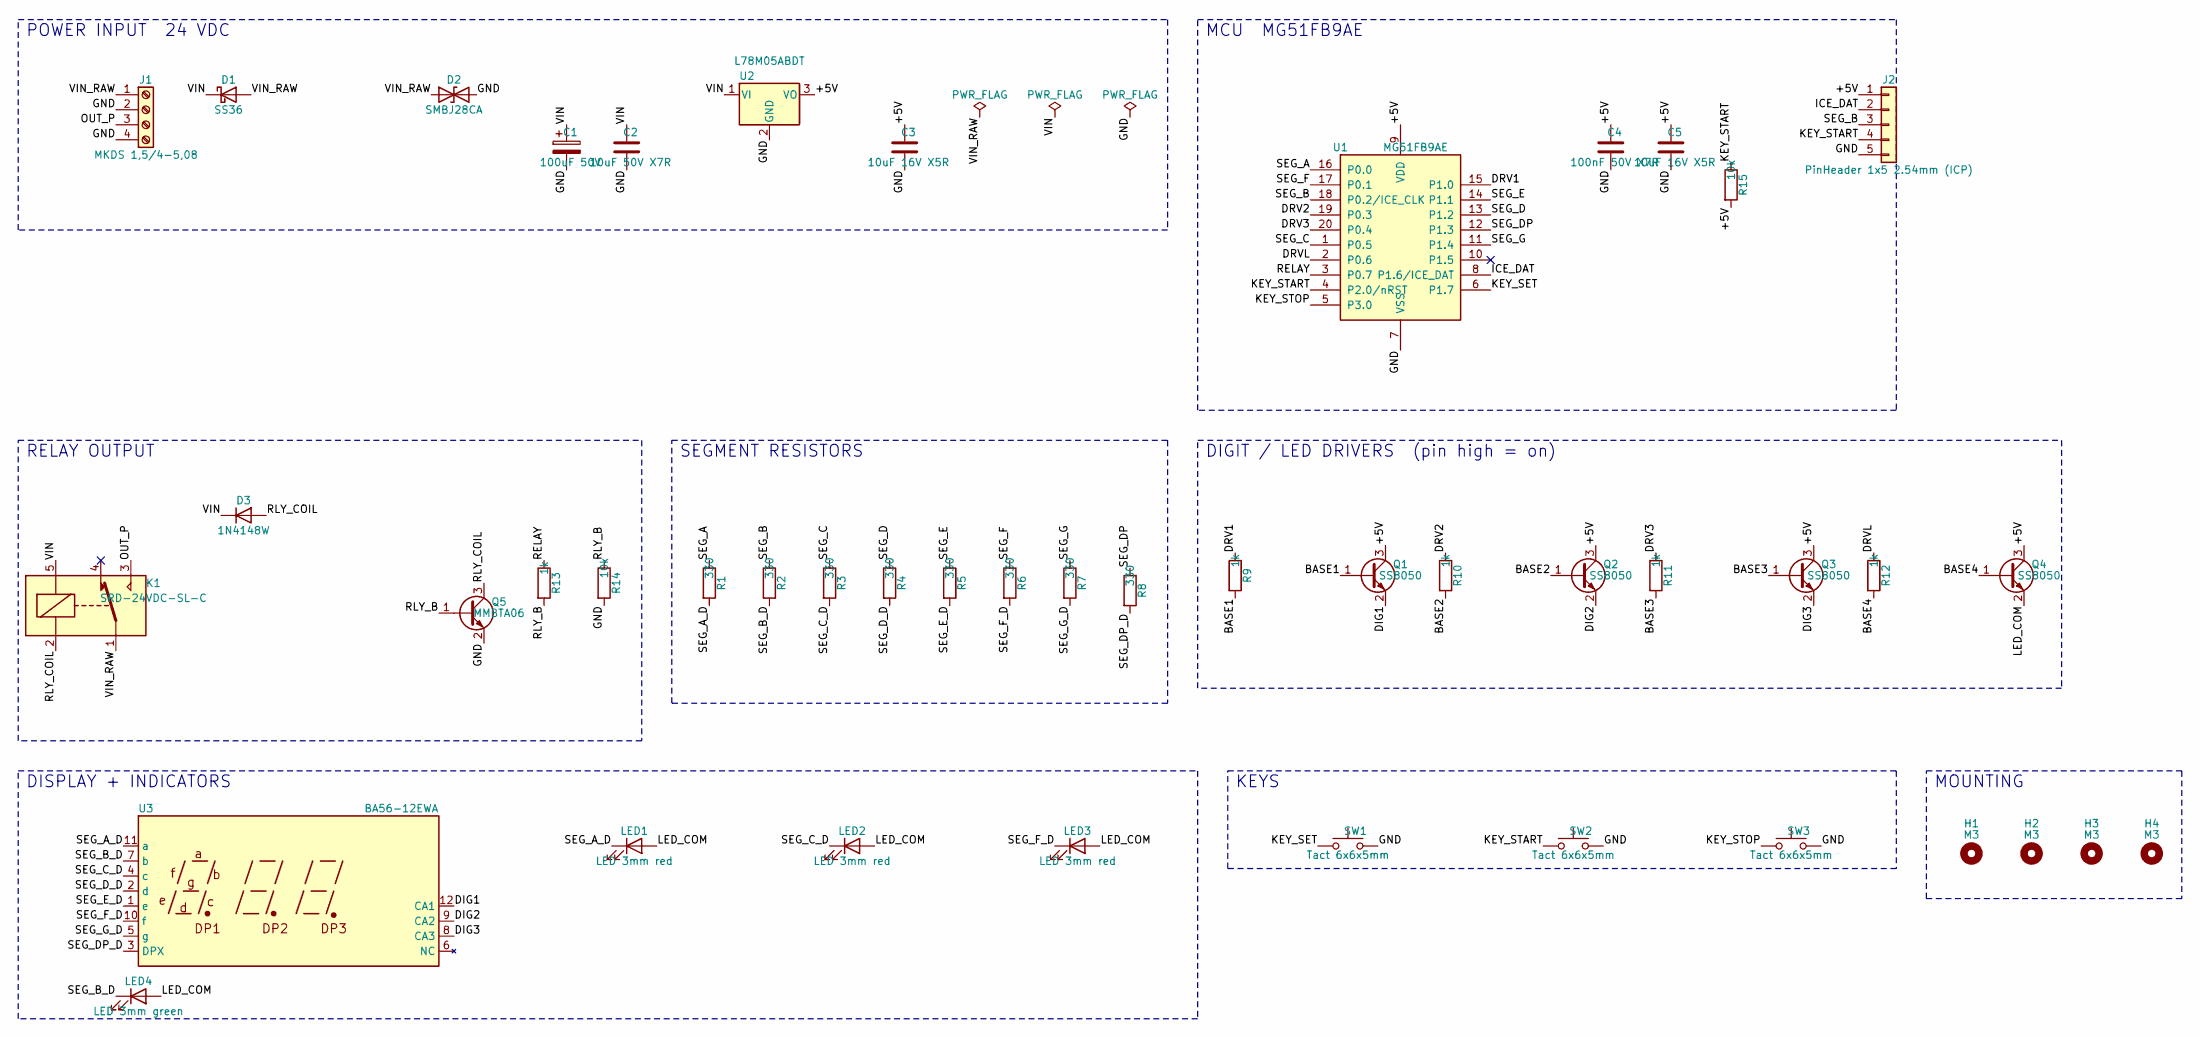
[picture p17: schematic timer.kicad_sch, CYTM Digital Timer V5]

Parts:
C1: 100uF 50V; CP_Radial_D8.0mm_P3.50mm
C2: 10uF 50V X7R; C_1206_3216Metric
C3, C5: 10uF 16V X5R; C_0805_2012Metric
C4: 100nF 50V X7R; C_0805_2012Metric
D1: SS36; D_SMA
D2: SMBJ28CA; D_SMB
D3: 1N4148W; D_SOD-123
H1, H2, H3, H4: M3; MountingHole_3.2mm_M3
J1: MKDS 1,5/4-5,08; TerminalBlock_Phoenix_MKDS-1,5-4-5.08_1x04_P5.08mm_Horizont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
J2: PinHeader 1x5 2.54mm (ICP); PinHeader_1x05_P2.54mm_Vertical
K1: SRD-24VDC-SL-C; Relay_SPDT_SANYOU_SRD_Series_Form_C
LED1, LED2, LED3: LED 3mm red; LED_D3.0mm
LED4: LED 3mm green; LED_D3.0mm
Q1, Q2, Q3, Q4: SS8050; SOT-23
Q5: MMBTA06; SOT-23
R1, R2, R3, R4, R5, R6, R7, R8: 330; R_0805_2012Metric
R9, R10, R11, R12, R13: 1k; R_0805_2012Metric
R14, R15: 10k; R_0805_2012Metric
SW1, SW2, SW3: Tact 6x6x5mm; SW_PUSH_6mm
U1: MG51FB9AE; TSSOP-20_4.4x6.5mm_P0.65mm
U2: L78M05ABDT; TO-252-2
U3: BA56-12EWA; Display_3Digit_0.56in_CA

Connections:
/+5V: C3.1, C4.1, C5.1, J2.1, Q1.3 (C), Q2.3 (C), Q3.3 (C), Q4.3 (C), R15.2, U1.9 (VDD), U2.3 (VO)
/BASE1: Q1.1 (B), R9.2
/BASE2: Q2.1 (B), R10.2
/BASE3: Q3.1 (B), R11.2
/BASE4: Q4.1 (B), R12.2
/DIG1: Q1.2 (E), U3.12 (CA1)
/DIG2: Q2.2 (E), U3.9 (CA2)
/DIG3: Q3.2 (E), U3.8 (CA3)
/DRV1: R9.1, U1.15 (P1.0)
/DRV2: R10.1, U1.19 (P0.3)
/DRV3: R11.1, U1.20 (P0.4)
/DRVL: R12.1, U1.2 (P0.6)
/GND: C1.2, C2.2, C3.2, C4.2, C5.2, D2.2 (A2), J1.2, J1.4, J2.5, Q5.2 (E), R14.2, SW1.2, SW2.2, SW3.2, U1.7 (VSS), U2.2 (GND)
/ICE_DAT: J2.2, U1.8 (P1.6/ICE_DAT)
/KEY_SET: SW1.1, U1.6 (P1.7)
/KEY_START: J2.4, R15.1, SW2.1, U1.4 (P2.0/nRST)
/KEY_STOP: SW3.1, U1.5 (P3.0)
/LED_COM: LED1.2 (A), LED2.2 (A), LED3.2 (A), LED4.2 (A), Q4.2 (E)
/OUT_P: J1.3, K1.3
/RELAY: R13.1, U1.3 (P0.7)
/RLY_B: Q5.1 (B), R13.2, R14.1
/RLY_COIL: D3.2 (A), K1.2, Q5.3 (C)
/SEG_A: R1.1, U1.16 (P0.0)
/SEG_A_D: LED1.1 (K), R1.2, U3.11 (a)
/SEG_B: J2.3, R2.1, U1.18 (P0.2/ICE_CLK)
/SEG_B_D: LED4.1 (K), R2.2, U3.7 (b)
/SEG_C: R3.1, U1.1 (P0.5)
/SEG_C_D: LED2.1 (K), R3.2, U3.4 (c)
/SEG_D: R4.1, U1.13 (P1.2)
/SEG_DP: R8.1, U1.12 (P1.3)
/SEG_DP_D: R8.2, U3.3 (DPX)
/SEG_D_D: R4.2, U3.2 (d)
/SEG_E: R5.1, U1.14 (P1.1)
/SEG_E_D: R5.2, U3.1 (e)
/SEG_F: R6.1, U1.17 (P0.1)
/SEG_F_D: LED3.1 (K), R6.2, U3.10 (f)
/SEG_G: R7.1, U1.11 (P1.4)
/SEG_G_D: R7.2, U3.5 (g)
/VIN: C1.1, C2.1, D1.1 (K), D3.1 (K), K1.5, U2.1 (VI)
/VIN_RAW: D1.2 (A), D2.1 (A1), J1.1, K1.1

Notes on the sheet:
POWER INPUT 24 VDC
MCU MG51FB9AE
RELAY OUTPUT
SEGMENT RESISTORS
DIGIT / LED DRIVERS (pin high = on)
DISPLAY + INDICATORS
KEYS
MOUNTING

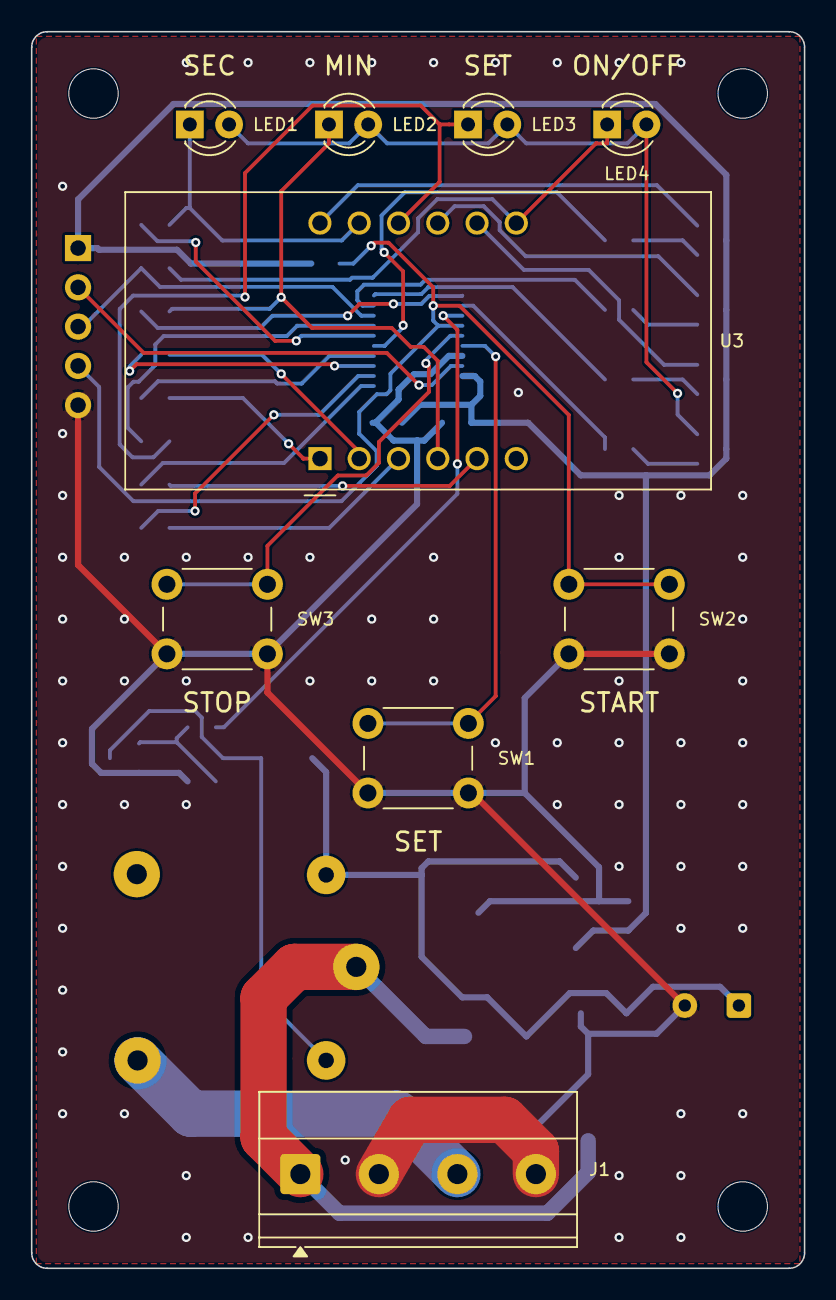
[picture p18: board timer.kicad_pcb from above]

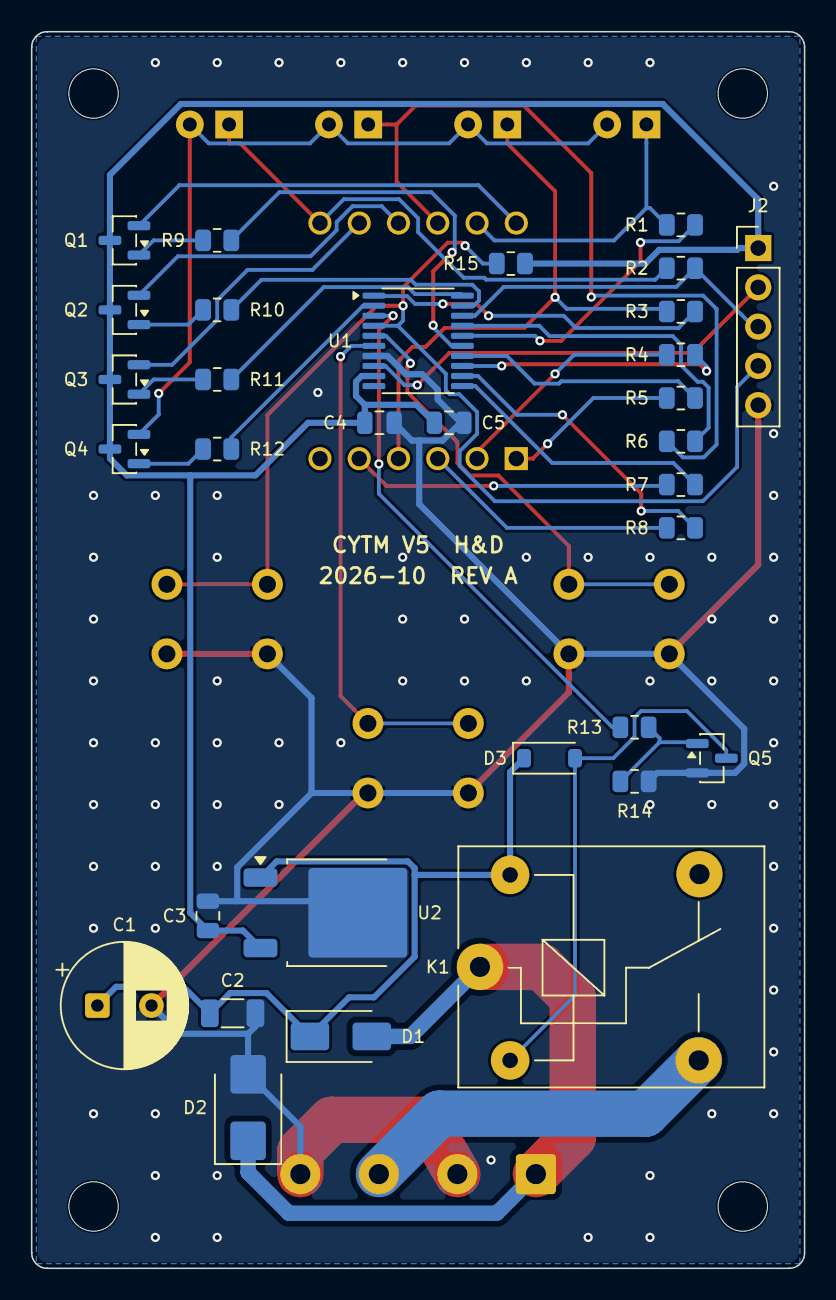
[picture p19: board timer.kicad_pcb from below]

Board: 2 copper layers, 50.0 x 80.0 mm, 45 parts (32 on the bottom side), 40 nets.
